JohnnyElectronic/BSG_Colonial_Viper_Mk1/README.md

# Battlestar Galactica Classic Viper

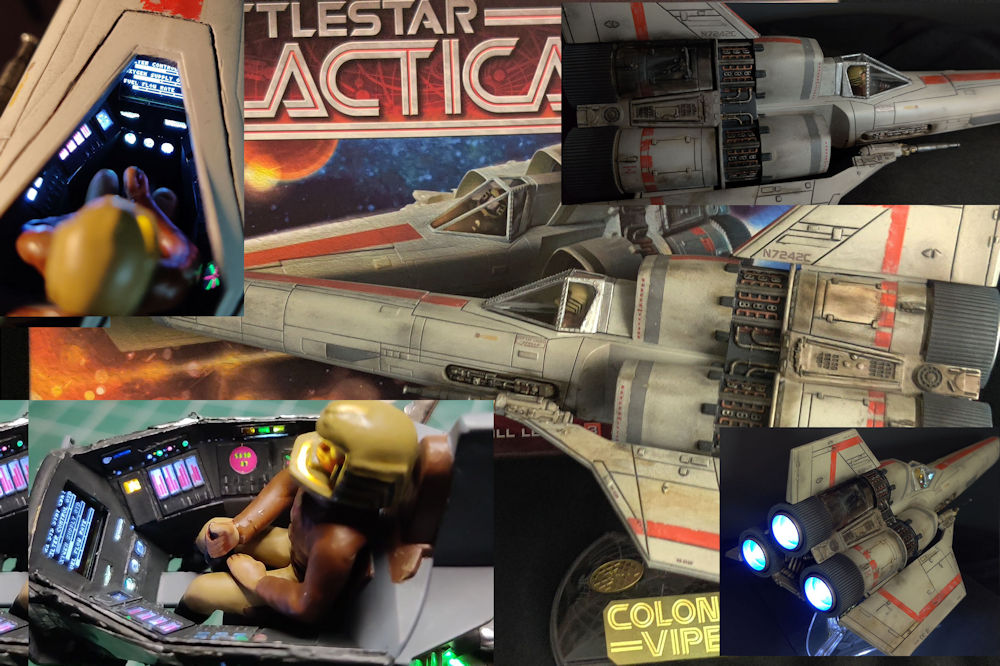
[picture p1: img/BSGViper_sm.jpg]


Here are the support files for my build of the 1/32nd Battlestar Galactica Classic Viper by Moebius Models. Released to commemorate the 35th Anniversary of the original series.
LED lighting, sound, and an active cockpit display have been added to bring this model to life. 
 
[See My YouTube Channel for more information](https://www.youtube.com/channel/UCbk7sF8TZ_Zz9eOcTYccMCg)

## This build will use the following components in the design:

**SR602 Motion Sensor**

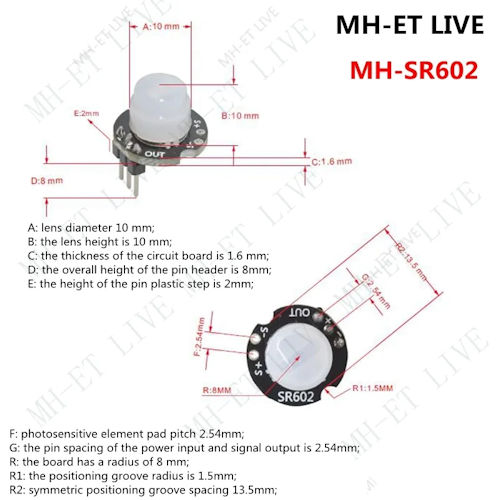
[picture p2: img/SR602_sm.jpg]
SR602 Motion Sensor


**DF Player Mini**

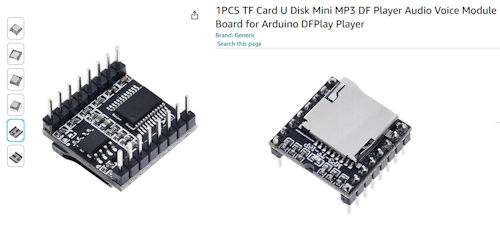
[picture p3: img/DFPlayer_sm.jpg]
DF Player Mini


Sound SD Card
Audio Play List (mp3 folder)
mp3
-	0001_BSG theme song.mp3
-	0002_Viper launch sequence.mp3
-	0003_BSG theme song clip.mp3
-	0004_target aquired.mp3
-	0005_target hit.mp3
-	0006_guns.mp3

**0.42" OLED Display**

Uses an SSD1306 display controller

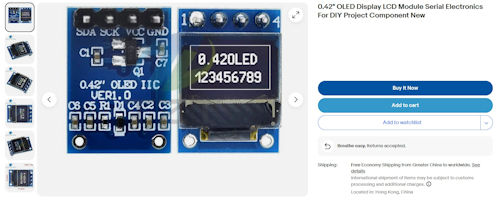
[picture p4: img/0_42_display_sm.jpg]
0.42" OLED Display


## Directories
- src: Contains Arduino sketch files
- lib: Associated Arduino libraries
- schematics: Images of the schematic design
- doc: Build documents 
- img: Images for this document
