JohnnyElectronic/BSG_Colonial_Viper_Mk1/img/BSG_V_Mk1_github.jpg

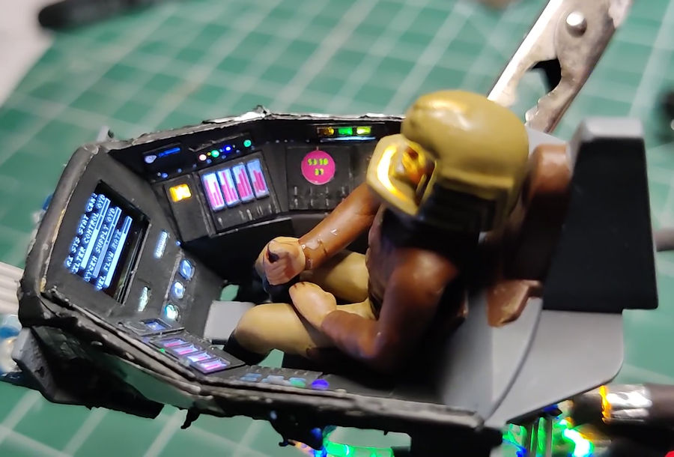
img/BSG_V_Mk1_github.jpg
