JohnnyElectronic/BSG_Colonial_Viper_Mk1/schematics/Viper_top.png

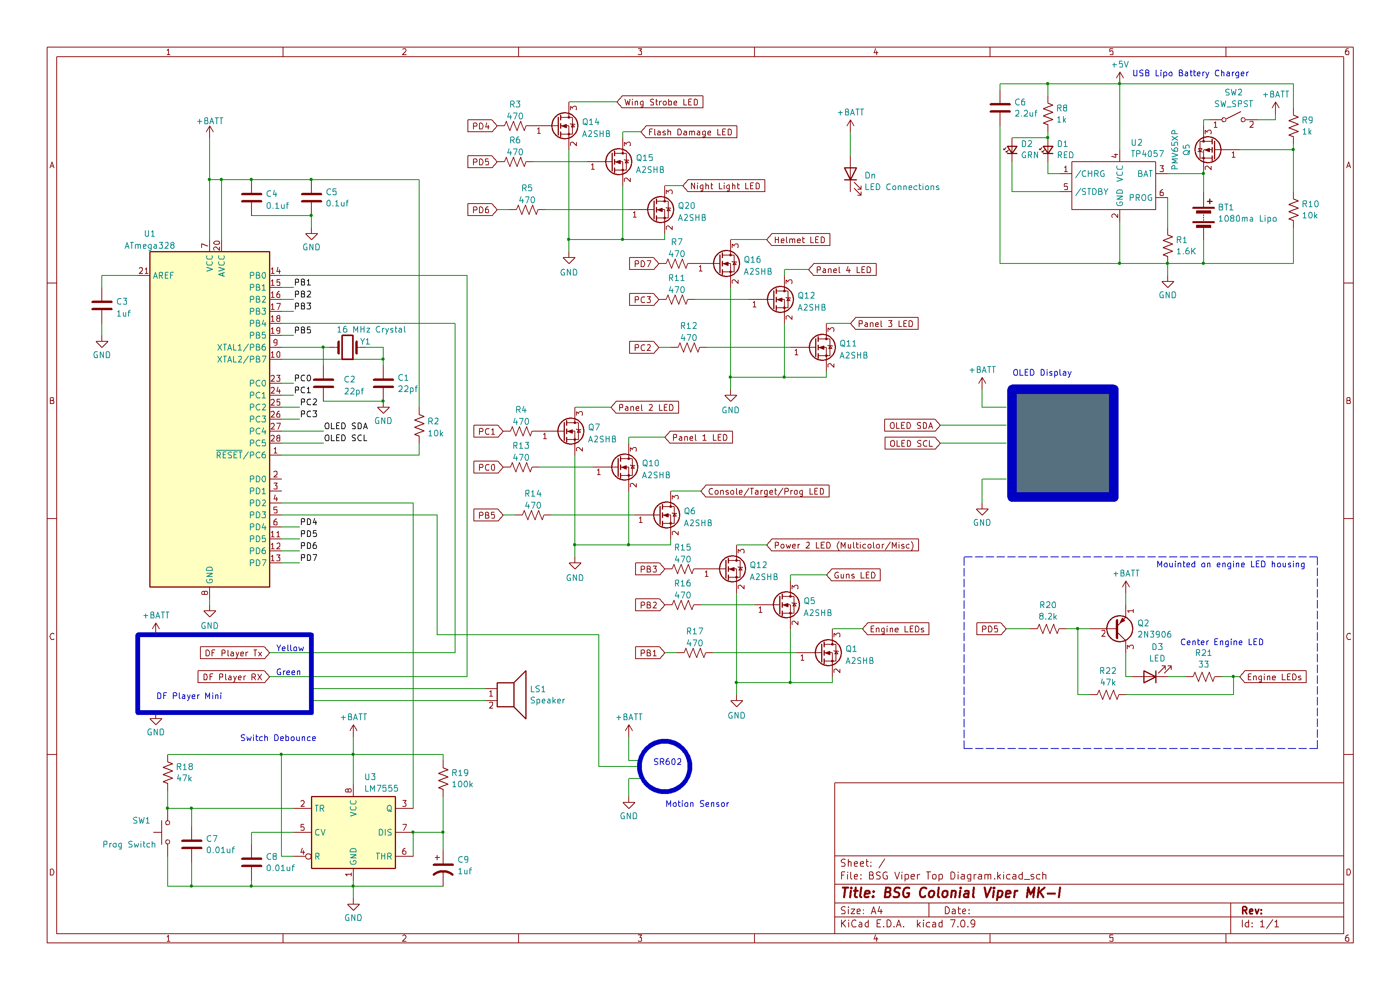
schematics/Viper_top.png
